willyci/esp32tracker/20260819_230617.jpg

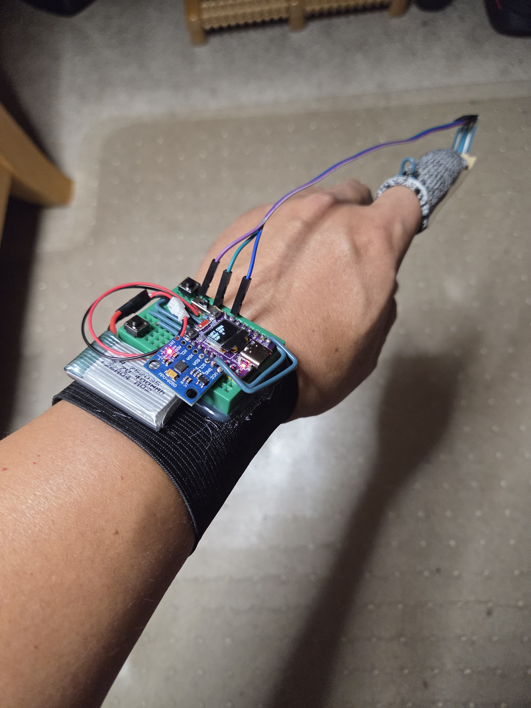
20260819_230617.jpg
