willyci/esp32tracker/20260819_230638.jpg

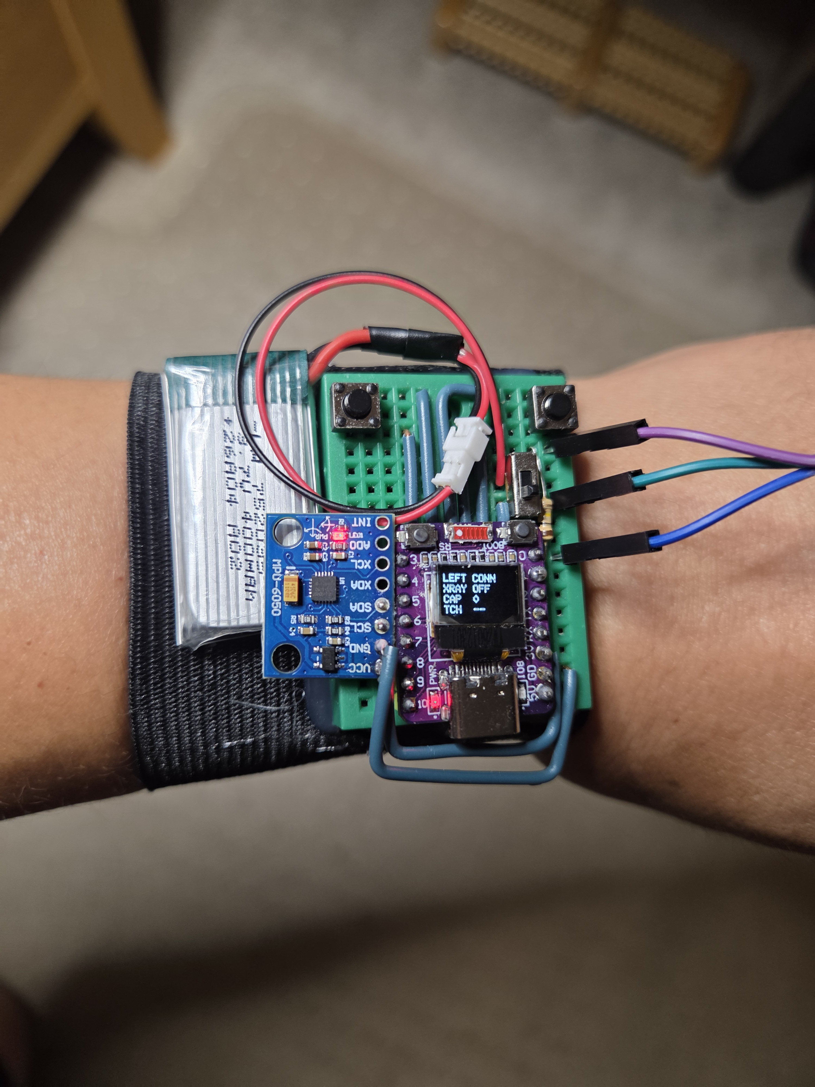
20260819_230638.jpg
