willyci/esp32tracker/20260819_230649.jpg

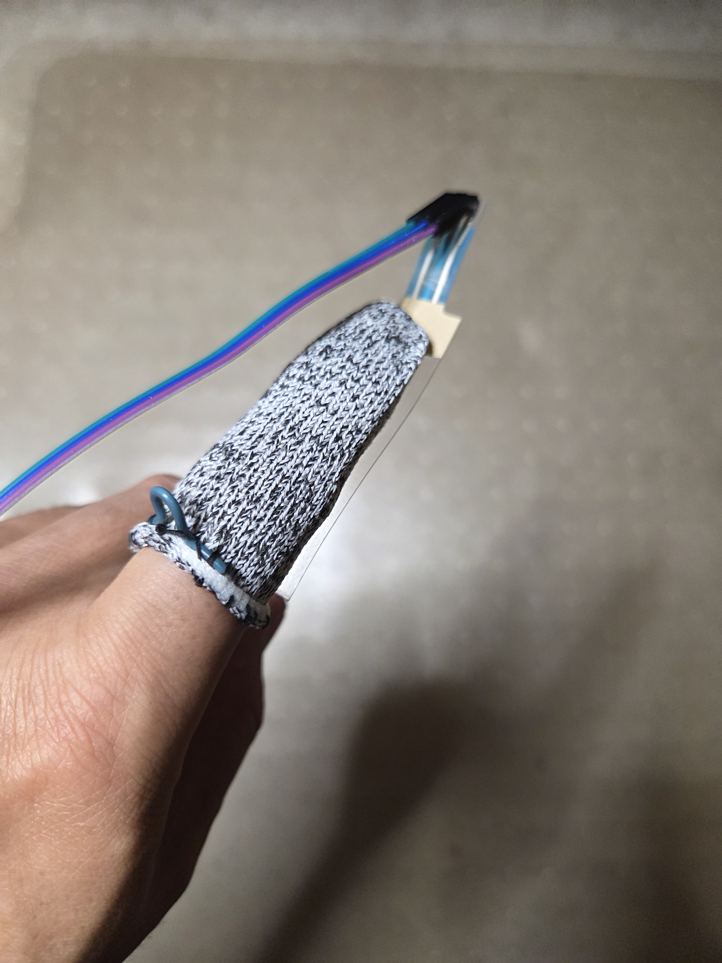
20260819_230649.jpg
