willyci/esp32tracker/20260819_230657.jpg

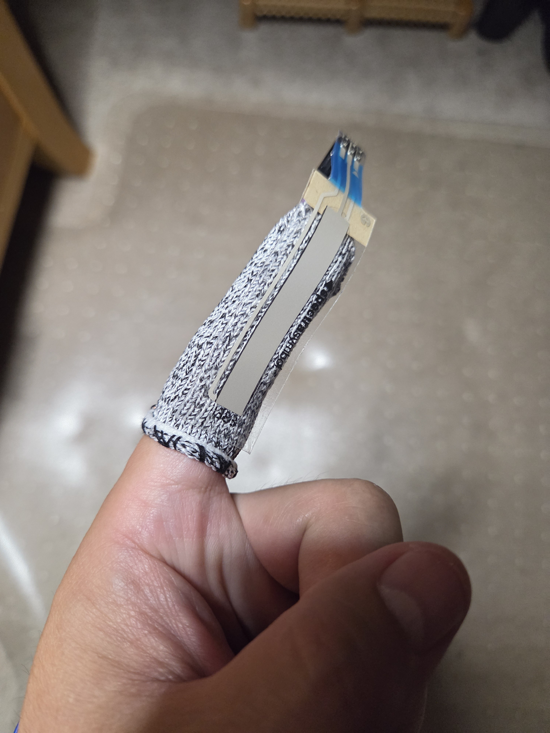
20260819_230657.jpg
