willyci/esp32tracker/20260819_230704.jpg

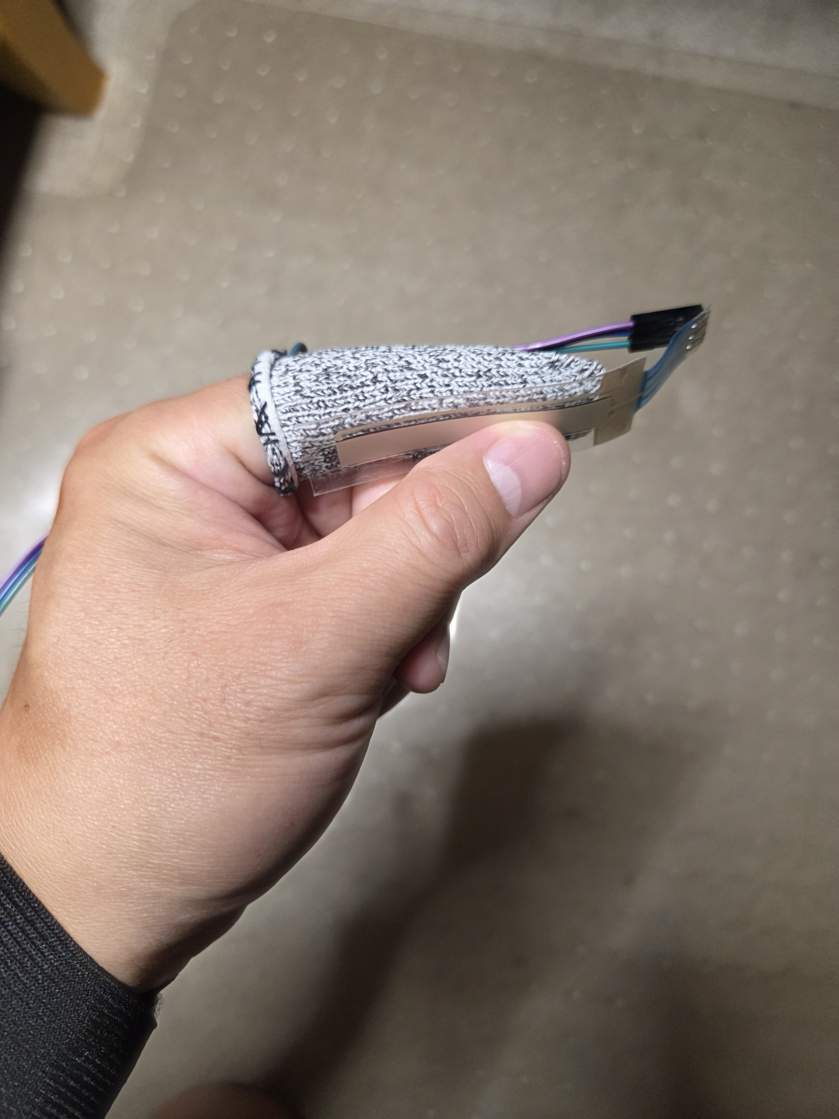
20260819_230704.jpg
