willyci/esp32tracker/20260819_230756.jpg

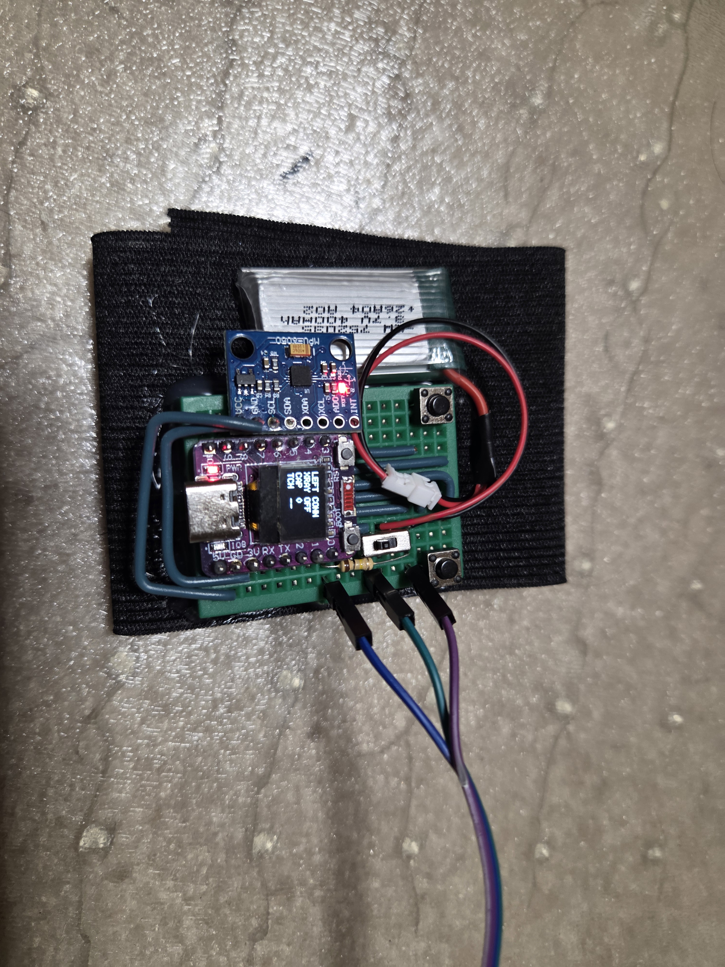
20260819_230756.jpg
