willyci/esp32tracker/(commit log)

2026-06-11 update display data pin for speed
2026-07-06 add button for x-ray toggle
2026-07-16 create mini version of the board
2026-07-20 fix screen flicker issue with battery
    [left-mini.ino, right-mini.ino]
2026-07-30 Fluoro pedal hold-to-activate + new DSA contrast pedal
    Two related pedal changes, plus the consumer-side work the broadcast
    re-architecture (b44e38b) still needed.
    Fluoro pedal (left-foot) is now a dead-man switch, not a toggle: X-ray is
    on for exactly as long as the pedal is down. A press counter cannot express
    "still held", so the broadcast gained a live level byte:
    mfg [0xFF,0xFF, pressCount, held]
    pressCount still increments per press, so a consumer reading only the
    counter keeps working (an un-updated app degrades to the old toggle).
    Advertising interval set to ~100-150 ms — on/off latency is one interval,
    and the NimBLE default (~1.28 s) felt sluggish.
    New DSA pedal (pedal 3, fir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
2026-07-30 Don't claim an unverified NimBLE default advertising interval
    The comment justified the explicit 100-150 ms interval by asserting the
    NimBLE default is ~1.28 s. That number is unverified — NimBLE may well
    default to something much faster. The design decision stands on its own
    (a level pedal's on/off latency is one advertising interval, so pin it
    rather than inherit it), so state that instead of a figure I can't back up.
    Comment-only; no behaviour change.
2026-07-30 Size pedal timeouts from measured ad delivery, not the TX interval
    Bench log showed all three pedals cycling "broadcast lost -> detected"
    every few seconds while idle. Measured why: a pedal advertising every
    100-150 ms (~7-10/s) is delivered to the Windows dashboard at only
    ~1-3 ads/s, with normal gaps up to ~3 s, because the host OS aggregates
    repeat advertisements from the same device. WinRT's SignalStrengthFilter
    sampling interval was tried and measured to make delivery WORSE, so there
    is no host-side knob for it.
    So the single 1.5 s window was simply wrong. Split it in two:
    LEVEL_RELEASE_AFTER (4 s) — clear a held level; this is the fail-safe
    PEDAL_OFFLINE_AFTER (5 s) — status o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
    [dsa-foot.ino, left-foot.ino]
2026-07-30 README: bring it up to five boards, two transports, and a Mac hand-off
    The README still described a two-device IMU demo. It now covers what the
    project actually is: two connected hand trackers (or the no-IMU Mini
    variants) plus three broadcast foot pedals, and why those two BLE
    transports differ (Vision Pro's connection budget).
    Added:
    - a board table mapping each sketch folder to its BLE name and role
    - the Mini tracker pin map, with the C3 constraints that forced it and the
    SoftPot centre-pin-is-the-wiper warning that cost a burned wire
    - flashing guidance that leads with the mistake this project keeps making
    (Arduino uploads the focused tab, so verify from the serial banner)
    - a "Con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
2026-08-17 Mini trackers: orientation from an MPU-6050 on the shared OLED bus
    The Mini boards were the no-IMU variant and sent an identity quaternion, so
    the cube never moved. They now carry an MPU-6050 wired to the OLED's own I2C
    bus (SDA GPIO5 / SCL GPIO6) — different addresses (0x3C vs 0x68), so it
    costs no extra pins and no wiring moves.
    The MPU-6050 does no fusion of its own (unlike the BNO085 on the big
    trackers), so the sketch integrates the gyro itself: bias calibration at
    boot while the board is held still, a deadband so a stationary board doesn't
    creep, and fixed-step 100 Hz integration feeding the existing 50 Hz notify.
    Accel is read in the same transaction and reported into the packet's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
    [left-mini.ino, right-mini.ino]
2026-08-17 Mini: try MPU-6050 at 0x69 as well, and point at the I2C scan when it fails
    A "NO IMU" report on correctly-wired hardware is most often the AD0 pin:
    GY-521 modules disagree about whether they pull it down (0x68), leave it
    floating, or pull it up (0x69), and the sketch only tried 0x68. Now it falls
    back to 0x69 and says which one it found.
    Also made the failure message actionable — it now tells you to read the [I2C]
    scan directly above it (no address at all = wiring/power; an unexpected
    address = the module), and states plainly that BLE keeps working regardless,
    so "no IMU" and "no Bluetooth" are not assumed to be the same fault.
    [left-mini.ino, right-mini.ino]
2026-08-17 Mini: survive a jammed I2C bus instead of hanging in display.begin()
    Bench symptom: serial printed the banner and "[OLED] begin..." and then
    stopped dead — no I2C scan, no BLE, blank screen. That is display.begin()
    blocking forever, which happens when a device on the shared bus holds SDA
    low (mis-wired, half-powered, or caught mid-byte by the ESP32 reset). One
    sick device takes the OLED and the whole board down with it.
    Three fixes so this fails loudly instead of silently:
    - i2cBusRecover(): if SDA is low before Wire starts, bit-bang up to 9 clocks
    plus a STOP to let the stuck slave finish its byte, and report whether SDA
    came back. This is the standard cure and costs nothing on a hea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
    [left-mini.ino, right-mini.ino]
2026-08-17 Mini: let U8g2 own I2C init — my explicit Wire.begin() hung display.begin()
    Bench log showed the I2C scan finding BOTH devices (0x3C OLED, 0x68
    MPU-6050) and then stopping dead at "[OLED] begin..." with no "[OLED] ready".
    So the wiring and the IMU were fine all along; display.begin() was hanging.
    Cause was mine. Adding the IMU, I introduced an explicit
    Wire.begin(SDA,SCL) before display.begin() to "set the bus up in one place".
    But U8g2 initialises Wire itself from the pins in its constructor, and
    pre-initialising it wedges U8g2's init — which then takes the screen, the
    scan and BLE down with it, because setup() never returns.
    Restored the ordering that worked before the IMU existed: d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
2026-08-17 Mini: drive the MPU-6050 directly — Adafruit's WHO_AM_I gate rejected the chip
    Bench log was conclusive: the I2C scan found 0x68 and the device ACKed, but
    Adafruit_MPU6050::begin() still failed at both addresses. That library's
    _init() reads WHO_AM_I and returns false unless it is exactly 0x68. Cheap
    GY-521 modules routinely ship a clone die (or an MPU-6500/9250) reporting
    0x70/0x72/0x98, so a perfectly working chip gets rejected.
    Replaced the library with ~60 lines of direct register access. The MPU-6xxx
    interface is simple and shared across the family: reset + wake via
    PWR_MGMT_1, DLPF/range/sample-rate config, then one 14-byte burst from
    ACCEL_XOUT_H so accel and gyro come from the sam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
    [left-mini.ino, right-mini.ino]
2026-08-21 mini version with small oled board and mpu-6050
2026-08-26 Touchscreen pedal panel on the ESP32-S3-Touch-AMOLED-2.06
    Replaces the three foot pedals with one screen: three full-width buttons
    (X-RAY / DSA / CAPTURE) on a 410x502 AMOLED, LRA haptics via a DRV2605L,
    speaker clicks through the ES8311, and a SoftPot input. Built on the
    Waveshare LVGL 9 example (CO5300 + FT3168), with the broadcast pattern
    lifted from firmware/dsa-foot.
    Three findings changed the original spec:
    - The SoftPot could not go on IO15 as asked: IO15/IO14 are the board's I2C
    bus (FT3168 touch, AXP2101, QMI8658, RTC), and an analog wiper there drags
    a digital bus to arbitrary voltages and kills all four. GPIO10 is the only
    free ADC1 pin but is not broken out, so the SoftPo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
    [pedal-panel.ino]
2026-08-27 Mini: bound gyro calibration, and divide by the samples actually read
    Bench symptom: the left Mini sat on "HOLD STILL..." indefinitely and never
    reached BLE. calibrateGyro() had no failure path — every failed I2C read
    burns two 50 ms Wire timeouts, so 300 samples against a flaky IMU took ~30 s
    with nothing on screen or serial to say anything was wrong.
    Worse, and quieter: the average divided by the requested sample count rather
    than the number that actually succeeded. Fifty good reads out of 300 produced
    a bias six times too small — a wrong calibration that would surface later as
    a drifting cube and look like a tuning problem rather than a bug.
    Now bounded three ways (consecutive-failu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
    [left-mini.ino, right-mini.ino]
2026-08-27 Panel: use the core-bundled BLE library instead of NimBLE
    The panel needs Arduino-ESP32 core 3.3.11 (Waveshare's stated version, and
    the only one with the ESP_I2S.h audio API), but I wrote its BLE layer against
    the NimBLE 1.4.x API that the rest of this repo uses. That does not work on
    3.x, and switching to NimBLE 2.x would have broken all five 2.0.17 boards,
    since the library version is shared across the sketchbook.
    Ported to the BLE library bundled with the core, so only the CORE has to be
    switched when moving between this board and the others — never the library.
    The advertisement is now assembled by hand: setAdvertisementData() replaces
    the auto-generated payload, and the visionOS ap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
    [pedal-panel.ino]
2026-08-27 Panel: drop the redundant lv_conf.h include
    Copied from the Waveshare example, but it is the next compile error waiting
    to happen in the IDE: lv_conf.h lives in the libraries ROOT, which is not on
    the include path (Waveshare's CI adds it via arduino-cli --libraries, the IDE
    does not). LVGL pulls its own config in regardless, through the
    "../../lv_conf.h" fallback in lv_conf_internal.h, so the explicit include
    bought nothing and only risked a failure.
    Context for the build that hit this: the Waveshare libraries (lvgl,
    Arduino_GFX, Arduino_DriveBus, XPowersLib, SensorLib, Mylibrary) and
    lv_conf.h are bundled in the vendor repo but were not in the sketchbook, so
    <lvgl.h> was simply not found.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
    [pedal-panel.ino]
2026-08-27 Panel: connected hand-slot tracker with QMI8658 orientation
    Requested: the panel's onboard QMI8658 should drive a cube the way the Minis'
    MPU-6050 does, with the panel taking over a hand slot.
    That made a better design available. Broadcast could not deliver smooth
    rotation — the host delivers only ~1-3 advertisements/second (measured for
    the foot pedals), which would step a cube along at 1-3 Hz. But because the
    panel REPLACES a hand rather than adding a device, connecting costs no extra
    Vision Pro slot, so it is now a GATT peripheral streaming the standard
    32-byte packet at 50 Hz like every other tracker. Converted from
    broadcast-only to a connected device advertising as "Left/Right Panel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
    [pedal-panel.ino]
2026-08-27 Panel: integrate over measured time, and push frames only when they change
    Asked how fast the data and screen update; working out the real numbers found
    a bug.
    At 80 MHz x 4 QSPI lines = 40 MB/s, one full 410x502x2 = 402 KB frame costs
    ~10.3 ms just to shift pixels, and loop() was pushing it EVERY pass whether
    anything had changed or not. That makes the loop ~15.3 ms (~65 Hz).
    The bug: the IMU gate advanced the quaternion by a hard-coded 10 ms per pass
    while 15.3 ms actually elapsed, so the cube rotated at roughly 65% of true
    speed — and worse whenever a click tone blocked the loop for 25-160 ms. A
    fixed step was fine on the Minis, whose loop is ~5 ms and has no framebuffer
    to push; it i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
    [pedal-panel.ino]
2026-08-27 Panel: two exclusive modes so it only pays for the half in use
    The board's two jobs are never needed at once and each is expensive, so run
    one at a time:
    PEDAL — screen + touch buttons drive X-ray/DSA/capture. IMU integration
    and the SoftPot are skipped; the quaternion HOLDS its last value
    (freezing beats zeroing, so the consumer's cube stays put instead
    of snapping to identity).
    TRACKER — orientation + SoftPot at full rate with the AMOLED genuinely
    POWERED DOWN via displayOff(), LVGL not run and no frames pushed.
    That reclaims the ~10 ms/frame of QSPI plus the panel's current,
    so 100 Hz integration and the 50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
    [pedal-panel.ino]
2026-08-27 Panel: freeze the screen in tracker mode instead of blanking it
    Asked whether the screen could be paused without powering off. It can, and
    that is now the default.
    The CO5300 has its own GRAM and self-refreshes the panel from it, so a pushed
    frame stays visible with zero host activity. "Pausing" therefore only means
    not running LVGL and not pushing pixels — exactly what tracker mode already
    did — and calling displayOff() on top of that was an extra choice, not a
    requirement. The CPU and QSPI saving is identical either way; the only
    difference is the glass.
    TRACKER_SCREEN_OFF selects:
    0 (default) FREEZE — the last frame stays up, costing panel current but
    leaving the b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
2026-08-30 Panel: actually calibrate the LRA, not just select LRA mode
    Asked whether the LRA was programmed. It was configured — useLRA(), the LRA
    effect library, internal-trigger mode, setWaveform/go per press — but never
    CALIBRATED, and for an LRA that is the gap that matters.
    An LRA is a resonant device: the DRV2605 drives it closed-loop at its
    resonant frequency (typically 170-235 Hz), tracking it via back-EMF. It
    cannot do that until auto-calibration has measured the motor, so an
    uncalibrated LRA buzzes weakly or barely moves — which is exactly what "LRA
    mode is set but the click feels wrong" looks like on the bench.
    The Adafruit library has no helper for this, but exposes raw register acc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
    [pedal-panel.ino]
2026-09-15 update , add camera, tracking hand
2026-09-16 hands tracking camera is working now
