willyci/esp32tracker/20260819_230738.jpg

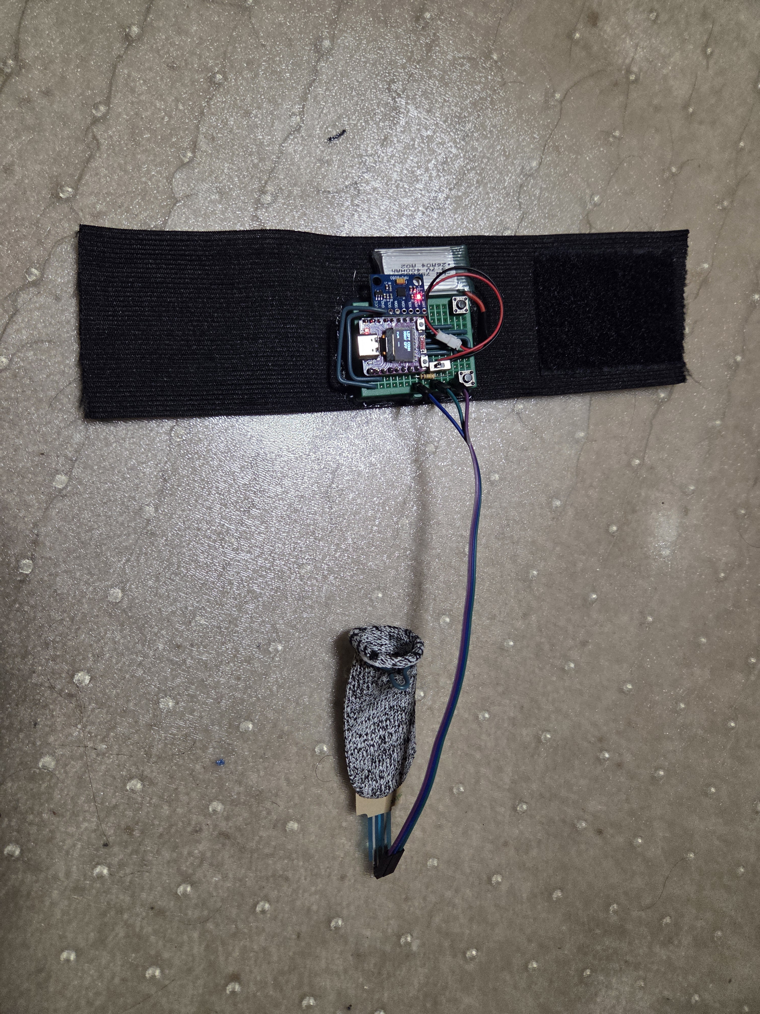
20260819_230738.jpg
