willyci/esp32tracker/20260819_230817.jpg

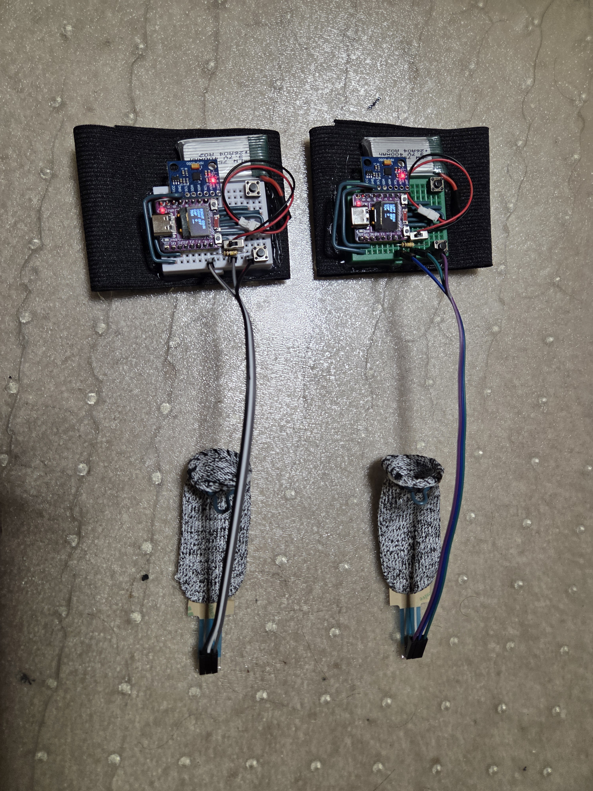
20260819_230817.jpg
