willyci/esp32tracker/20260707_215921.jpg

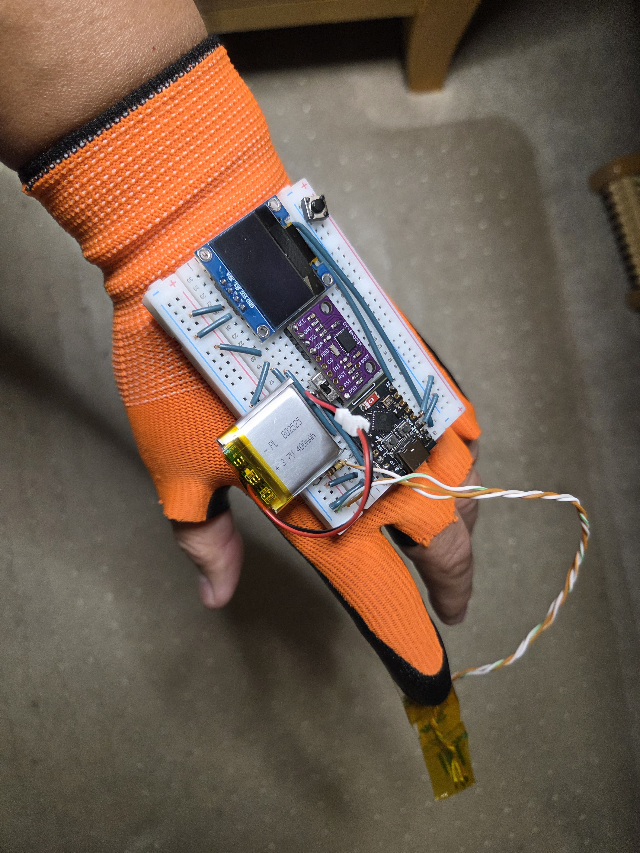
[picture p1: 20260707_215921.jpg]
20260707_215921.jpg
