willyci/esp32tracker/20260707_215927.jpg

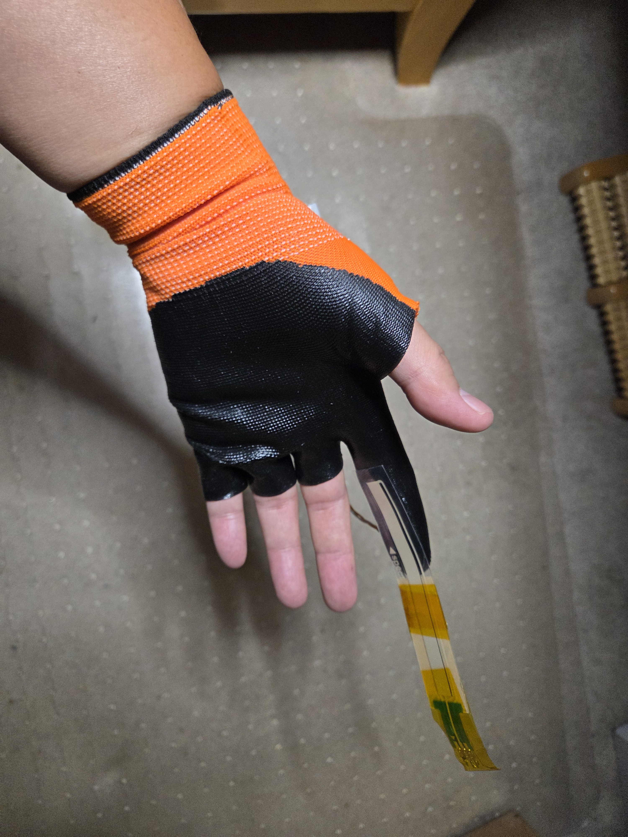
[picture p2: 20260707_215927.jpg]
20260707_215927.jpg
