willyci/esp32tracker/20260707_215935.jpg

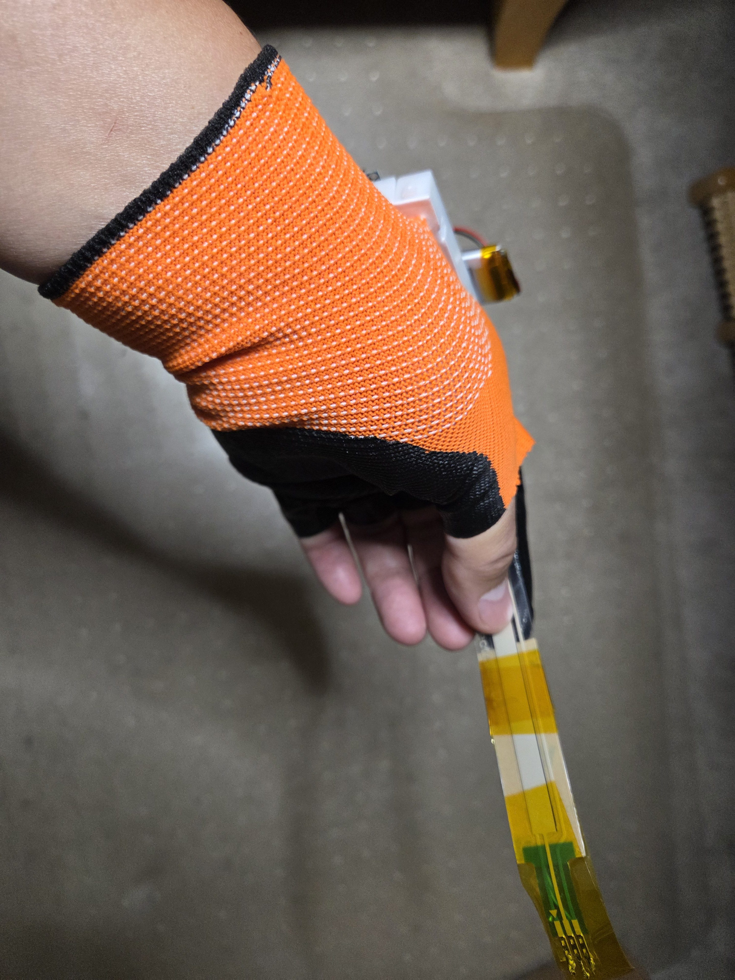
[picture p3: 20260707_215935.jpg]
20260707_215935.jpg
